geraicerdas/Cerdas-UWB-Tracker/Arduino Library/readme.txt

Updated 11 February 2025
- Add compatibility for ESP32-S3

Updated 04 April 2023
- Add functionality for high power DWM1000
