geraicerdas/Cerdas-UWB-Tracker/(threads)

Thread 1 (2022-09-22):

Board Outline File Missing

rajsalieabs, 2022-09-22:
Hi @geraicerdas the board outline file is missing in the gerber / production pack. Can you please include it?

geraicerdas, 2022-09-23:
Hi @rajsalieabs
All you need is already there. Please check again your gerber viewer. You can also double check the file using text editor.
Below shown the outline layer.

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
