geraicerdas/Cerdas-UWB-Tracker/hardware/Cerdas UWB Tracker V3R0 Public.pdf

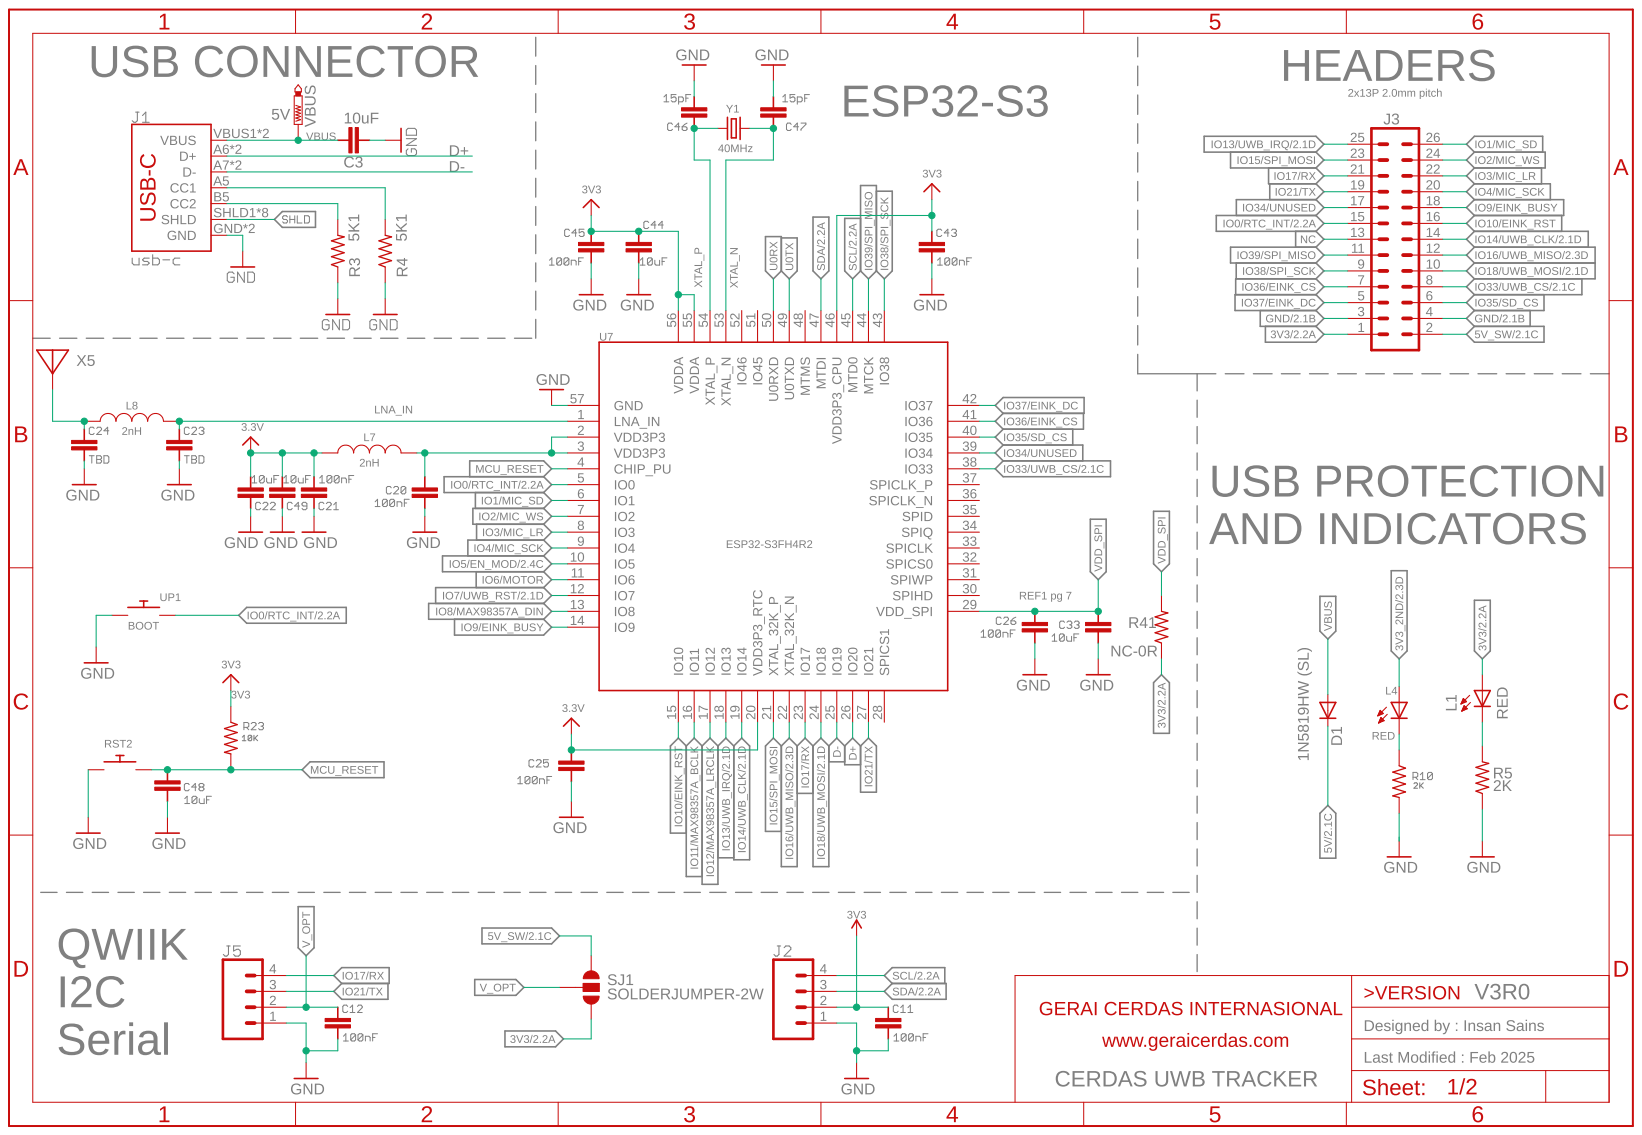
[picture p2: page 1]

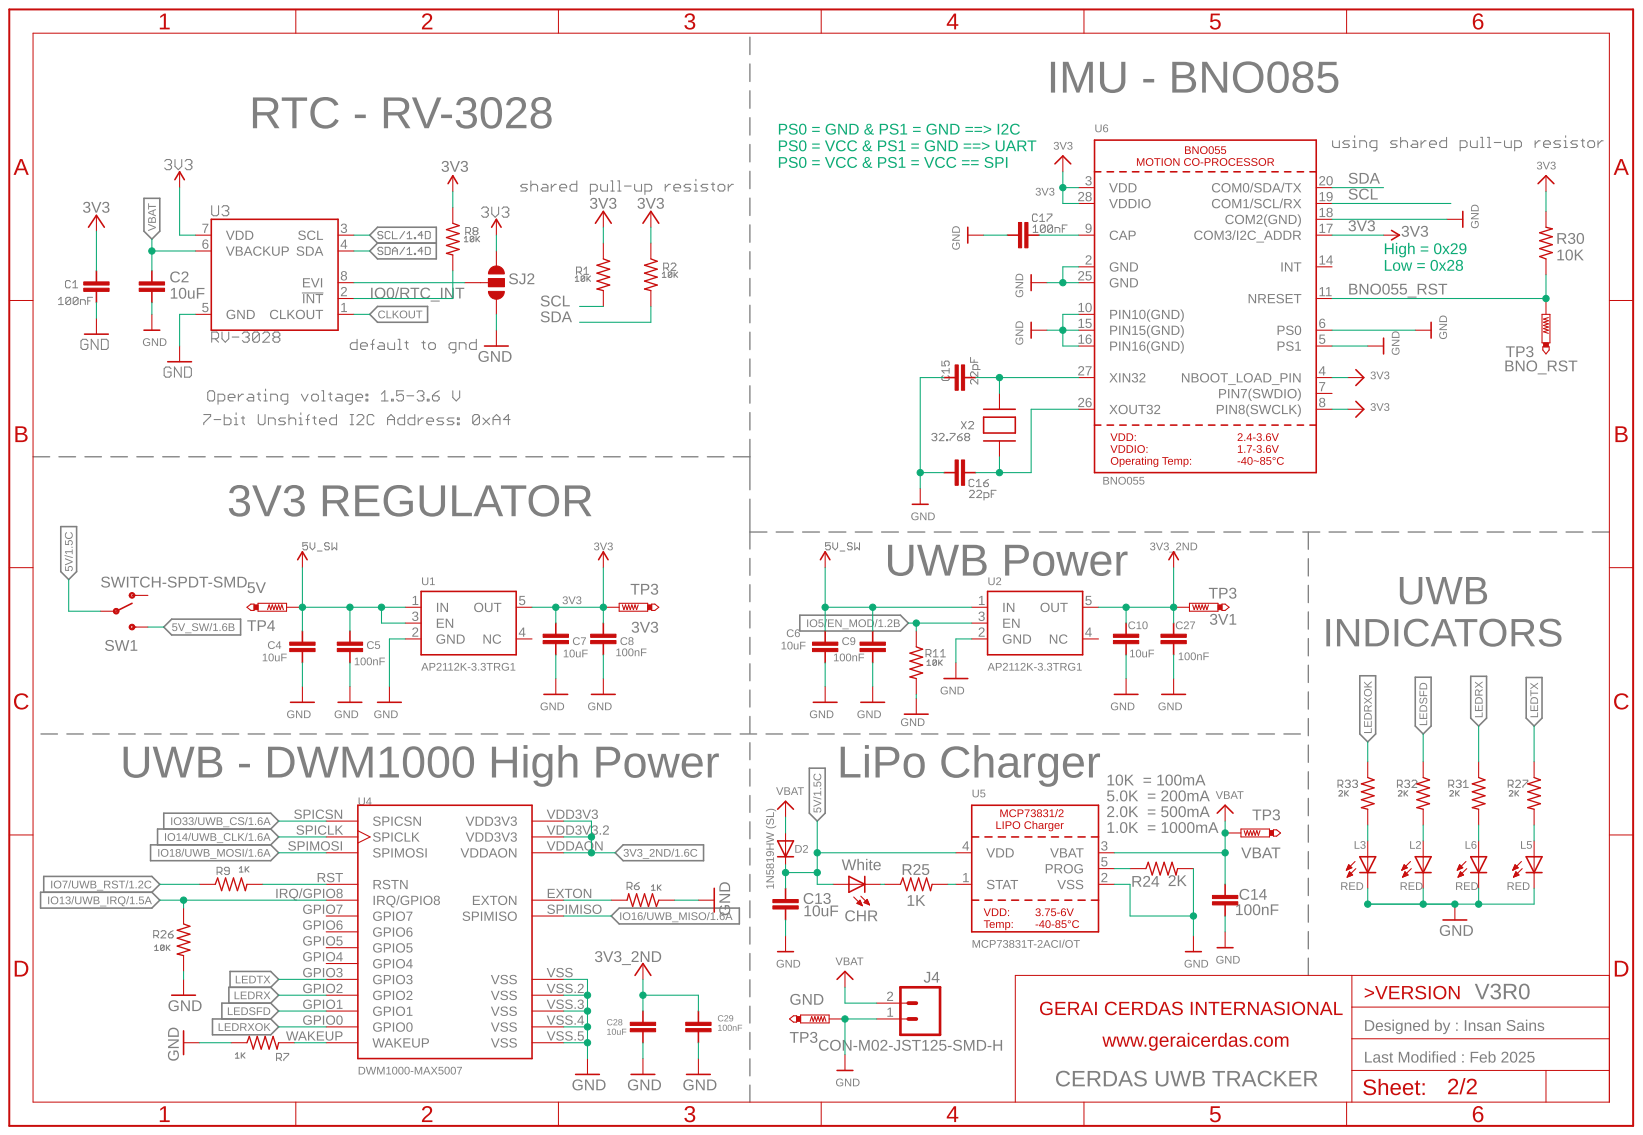
[picture p3: page 2]
