geraicerdas/Cerdas-UWB-Tracker/hardware/V1/ESP32 UWB Public V1.pdf

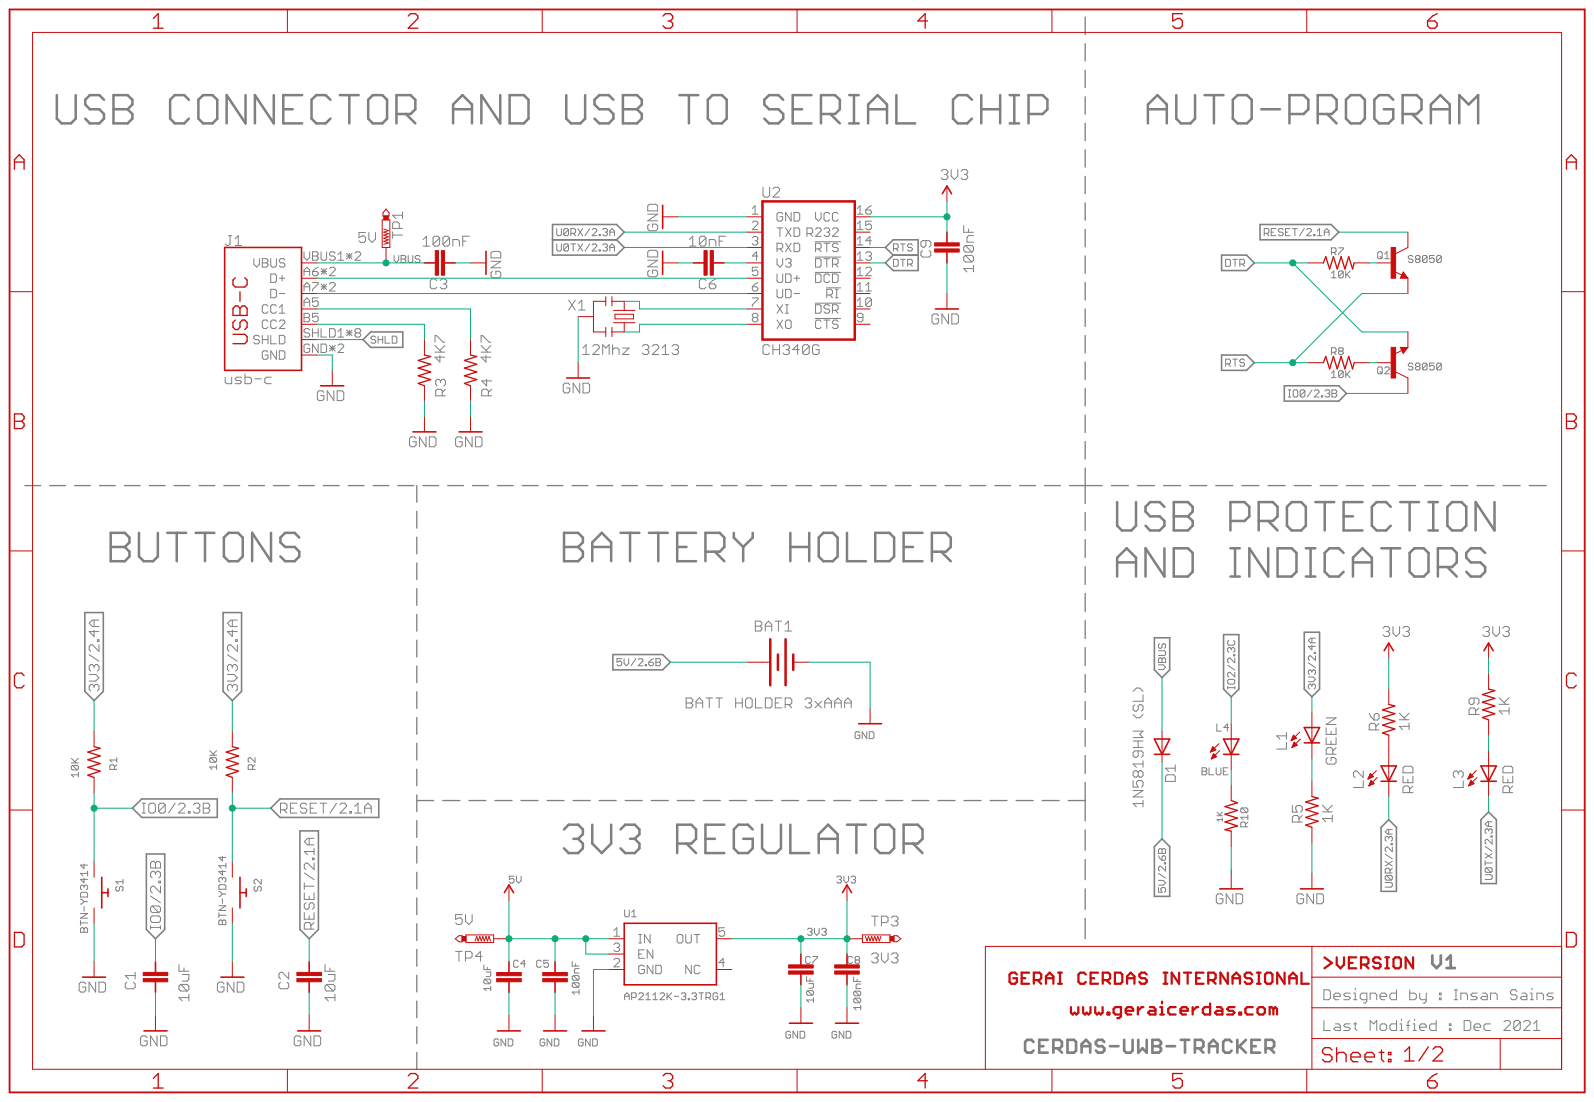
[picture p4: page 1]

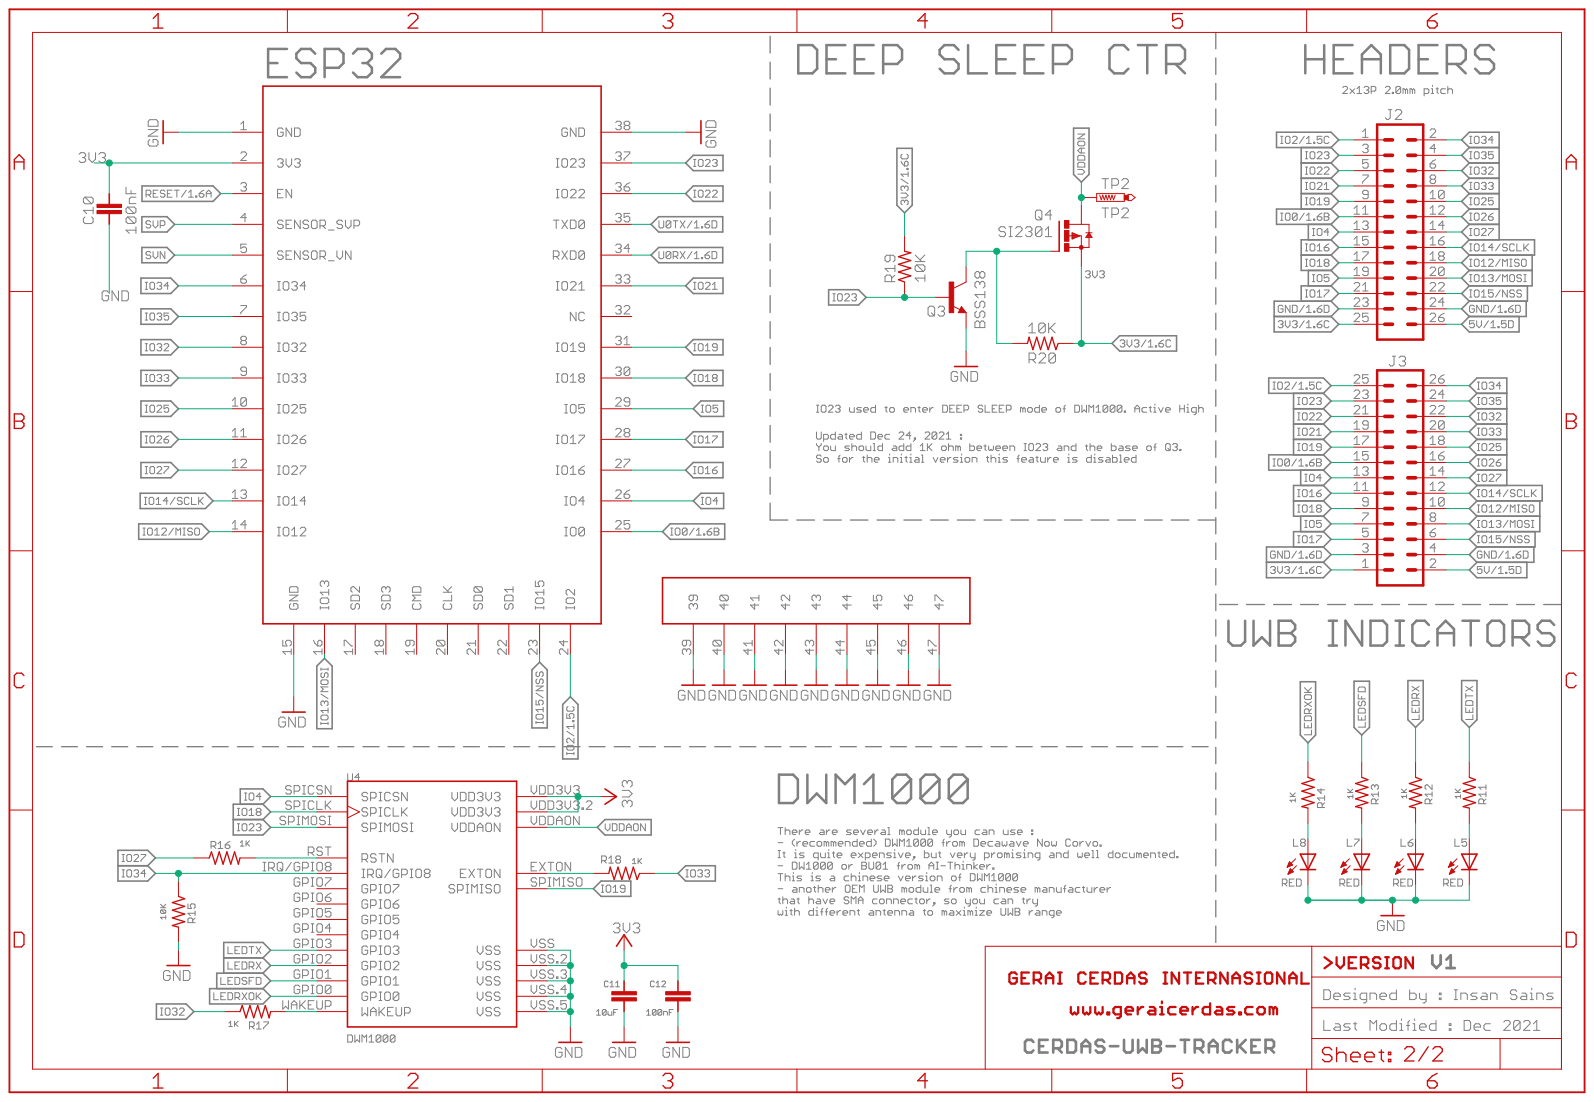
[picture p5: page 2]
