geraicerdas/Cerdas-UWB-Tracker/Arduino Library/DWM1000/examples/Cerdas_UWB_Tracker_Setup_Anchor/Cerdas_UWB_Tracker_Setup_Anchor.ino

/* Cerdas UWB Tracker V3.0 (will not work for previous version)

 * Please set :
 * USB CDC On Boot : "Enabled" 
 * USB DFU On Boot : "Disabled"
 * USB Firmware MSC On Boot : "Disabled"
 * Upload Mode : "UART0/Hardware CDC"
 * USB Mode : "USB-OTG (TinyUSB)"
 */


//anchor #4 setup


// be sure to edit anchor_addr and select the previously calibrated anchor delay
// my naming convention is anchors 1, 2, 3, ... have the lowest order byte of the MAC address set to 81, 82, 83, ...

#include <SPI.h>
#include "DW1000Ranging.h"
#include "DW1000.h"

// leftmost two bytes below will become the "short address"
char anchor_addr[] = "84:00:5B:D5:A9:9A:E2:9C"; //#4

//calibrated Antenna Delay setting for this anchor
uint16_t Adelay = 16580;

// previously determined calibration results for antenna delay
// #1 16630
// #2 16610
// #3 16607
// #4 16580

// calibration distance
//float dist_m = (285 - 1.75) * 0.0254; //meters

#define EN_UWB 5

#define SPI_SCK 14
#define SPI_MISO 16
#define SPI_MOSI 18
#define DW_CS 33

// connection pins
const uint8_t PIN_RST = 7; // reset pin
const uint8_t PIN_IRQ = 13; // irq pin
const uint8_t PIN_SS = 33;   // spi select pin

void setup() {
  // turn on UWB Module
  pinMode(EN_UWB, OUTPUT);
  digitalWrite(EN_UWB, HIGH);
  
  Serial.begin(115200);
  delay(1000); //wait for serial monitor to connect
  Serial.println("Anchor config and start");
  Serial.print("Antenna delay ");
  Serial.println(Adelay);
  //Serial.print("Calibration distance ");
  //Serial.println(dist_m);

  //init the configuration
  SPI.begin(SPI_SCK, SPI_MISO, SPI_MOSI);
  DW1000Ranging.initCommunication(PIN_RST, PIN_SS, PIN_IRQ); //Reset, CS, IRQ pin

  // set antenna delay for anchors only. Tag is default (16384)
  DW1000.setAntennaDelay(Adelay);

  DW1000Ranging.attachNewRange(newRange);
  DW1000Ranging.attachNewDevice(newDevice);
  DW1000Ranging.attachInactiveDevice(inactiveDevice);
  
  //DM1000 indicator LED
  DW1000.enableDebounceClock();
  DW1000.enableLedBlinking();
  DW1000.setGPIOMode(MSGP0, LED_MODE);  

  //start the module as an anchor, do not assign random short address
  DW1000Ranging.startAsAnchor(anchor_addr, DW1000.MODE_LONGDATA_RANGE_LOWPOWER, false);
  // DW1000Ranging.startAsAnchor(ANCHOR_ADD, DW1000.MODE_SHORTDATA_FAST_LOWPOWER);
  // DW1000Ranging.startAsAnchor(ANCHOR_ADD, DW1000.MODE_LONGDATA_FAST_LOWPOWER);
  // DW1000Ranging.startAsAnchor(ANCHOR_ADD, DW1000.MODE_SHORTDATA_FAST_ACCURACY);
  // DW1000Ranging.startAsAnchor(ANCHOR_ADD, DW1000.MODE_LONGDATA_FAST_ACCURACY);
  // DW1000Ranging.startAsAnchor(ANCHOR_ADD, DW1000.MODE_LONGDATA_RANGE_ACCURACY);
}

void loop() {
  DW1000Ranging.loop();
}

void newRange() {
  //    Serial.print("from: ");
  Serial.print(DW1000Ranging.getDistantDevice()->getShortAddress(), HEX);
  Serial.print(", ");

#define NUMBER_OF_DISTANCES 1
  float dist = 0.0;
  for (int i = 0; i < NUMBER_OF_DISTANCES; i++) {
    dist += DW1000Ranging.getDistantDevice()->getRange();
  }
  dist = dist/NUMBER_OF_DISTANCES;
  Serial.println(dist);
}

void newDevice(DW1000Device *device) {
  Serial.print("Device added: ");
  Serial.println(device->getShortAddress(), HEX);
}

void inactiveDevice(DW1000Device *device) {
  Serial.print("Delete inactive device: ");
  Serial.println(device->getShortAddress(), HEX);
}
